aequorea/palomino/gerber/readme.md

Here are the gerber files created by Tango PCB. In principle you could make circuit boards. In practice I might suggest doing a new layout with something more modern. It's a pretty simple design.
