aequorea/palomino/Battery Charger Lab Notes 5-16-94 ---1.jpg

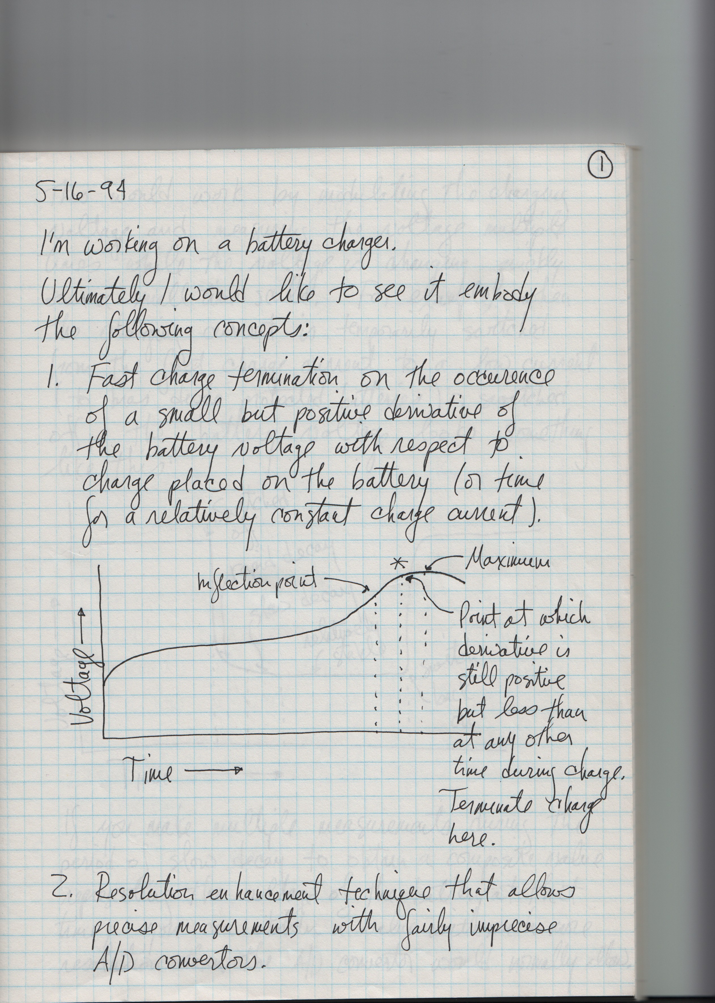
Battery Charger Lab Notes 5-16-94 ---1.jpg
