aequorea/palomino/Battery Charger Lab Notes 5-16-94 ---2.jpg

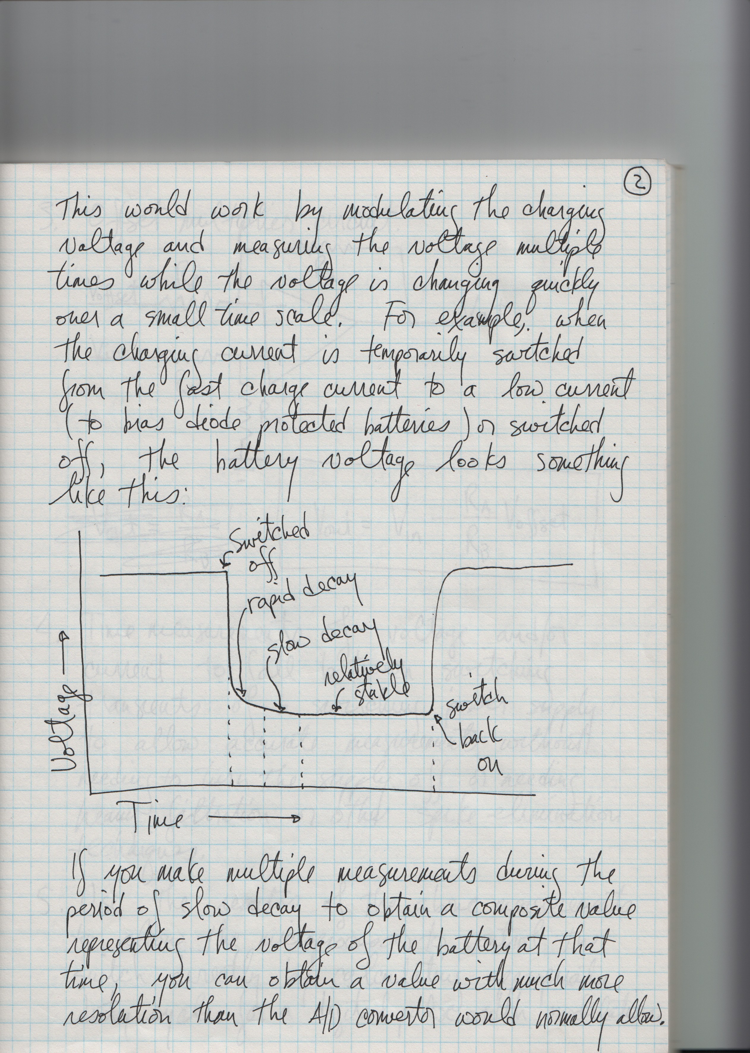
Battery Charger Lab Notes 5-16-94 ---2.jpg
