aequorea/palomino/Palomino_B.jpg

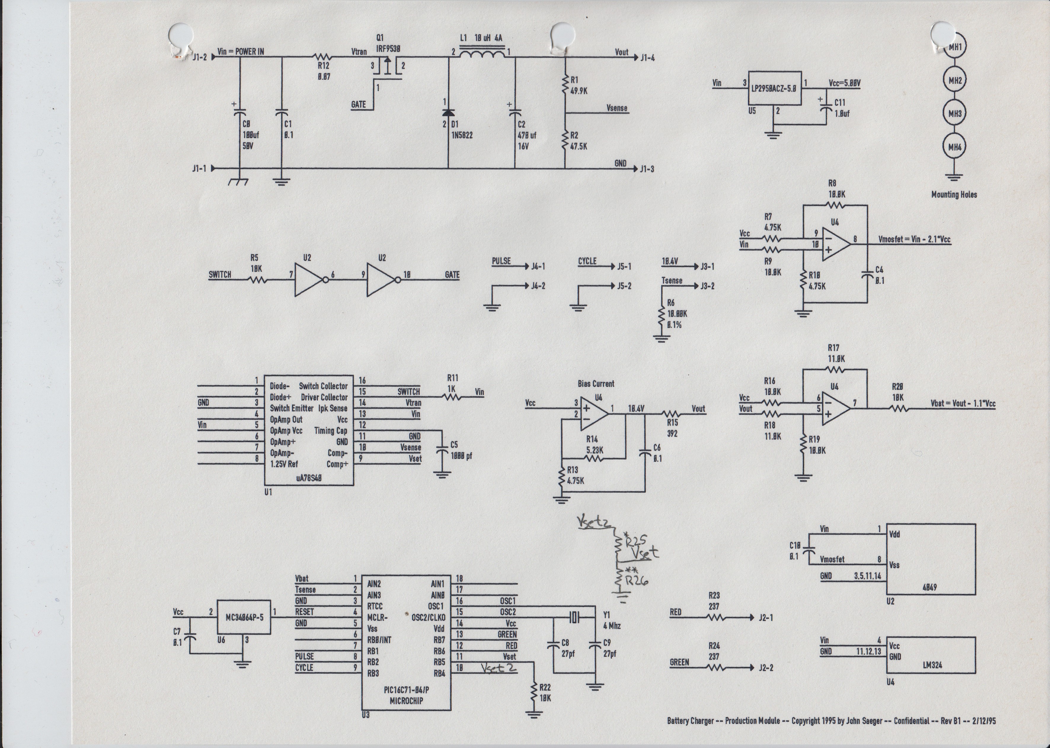
Palomino_B.jpg
