aequorea/palomino/(list of files, cad)

Other CAD files:
sw/CHARGERF.OBJ
