aequorea/palomino/(list of files, drawings)

Other design files:
revb/PALOMINO.PCB
